mu-0/motorcontroller/kicad/parts/models/TO-220_STM.step

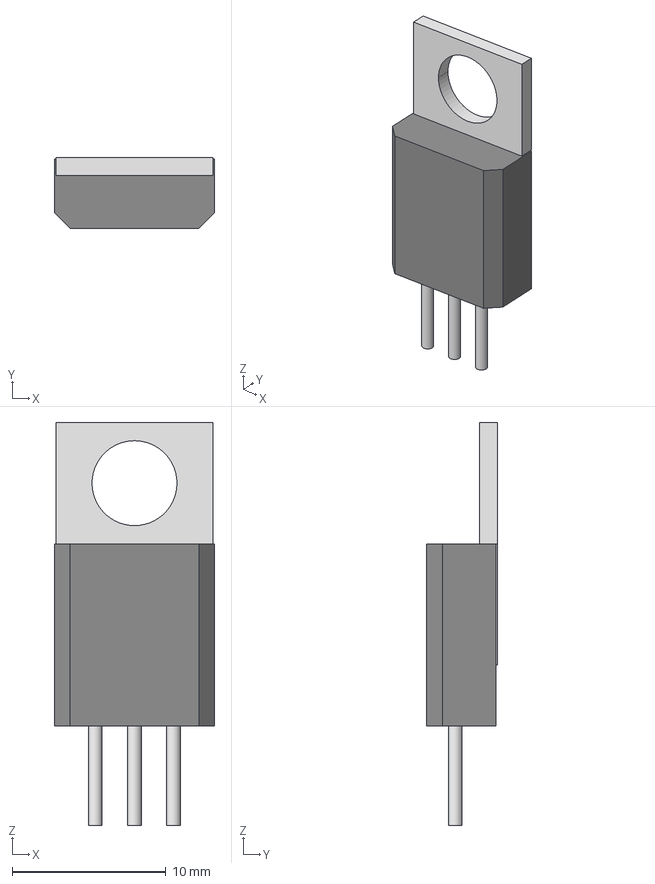
[picture p2: CAD file, 2020-12-27]
kicad/parts/models/TO-220_STM.step
10.4 x 4.60 x 26.2 mm
