mu-0/motorcontroller/kicad/parts/models/SO-8_STM.step

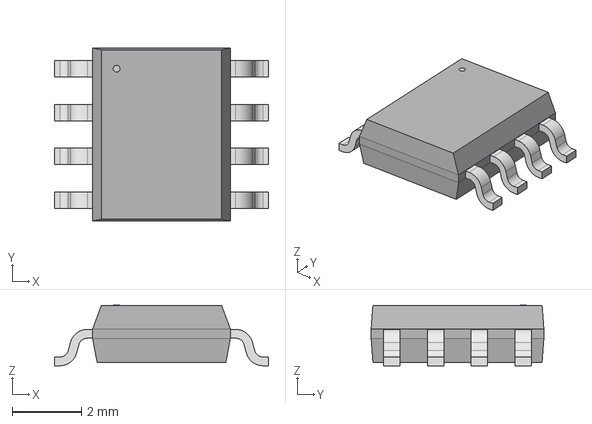
[picture p3: CAD file, 2020-12-27]
kicad/parts/models/SO-8_STM.step
6.20 x 5.00 x 1.75 mm
