mu-0/motorcontroller/kicad/motorcontroller.kicad_pcb

## KiCad design kicad/motorcontroller.kicad_pcb (2020-12-27)

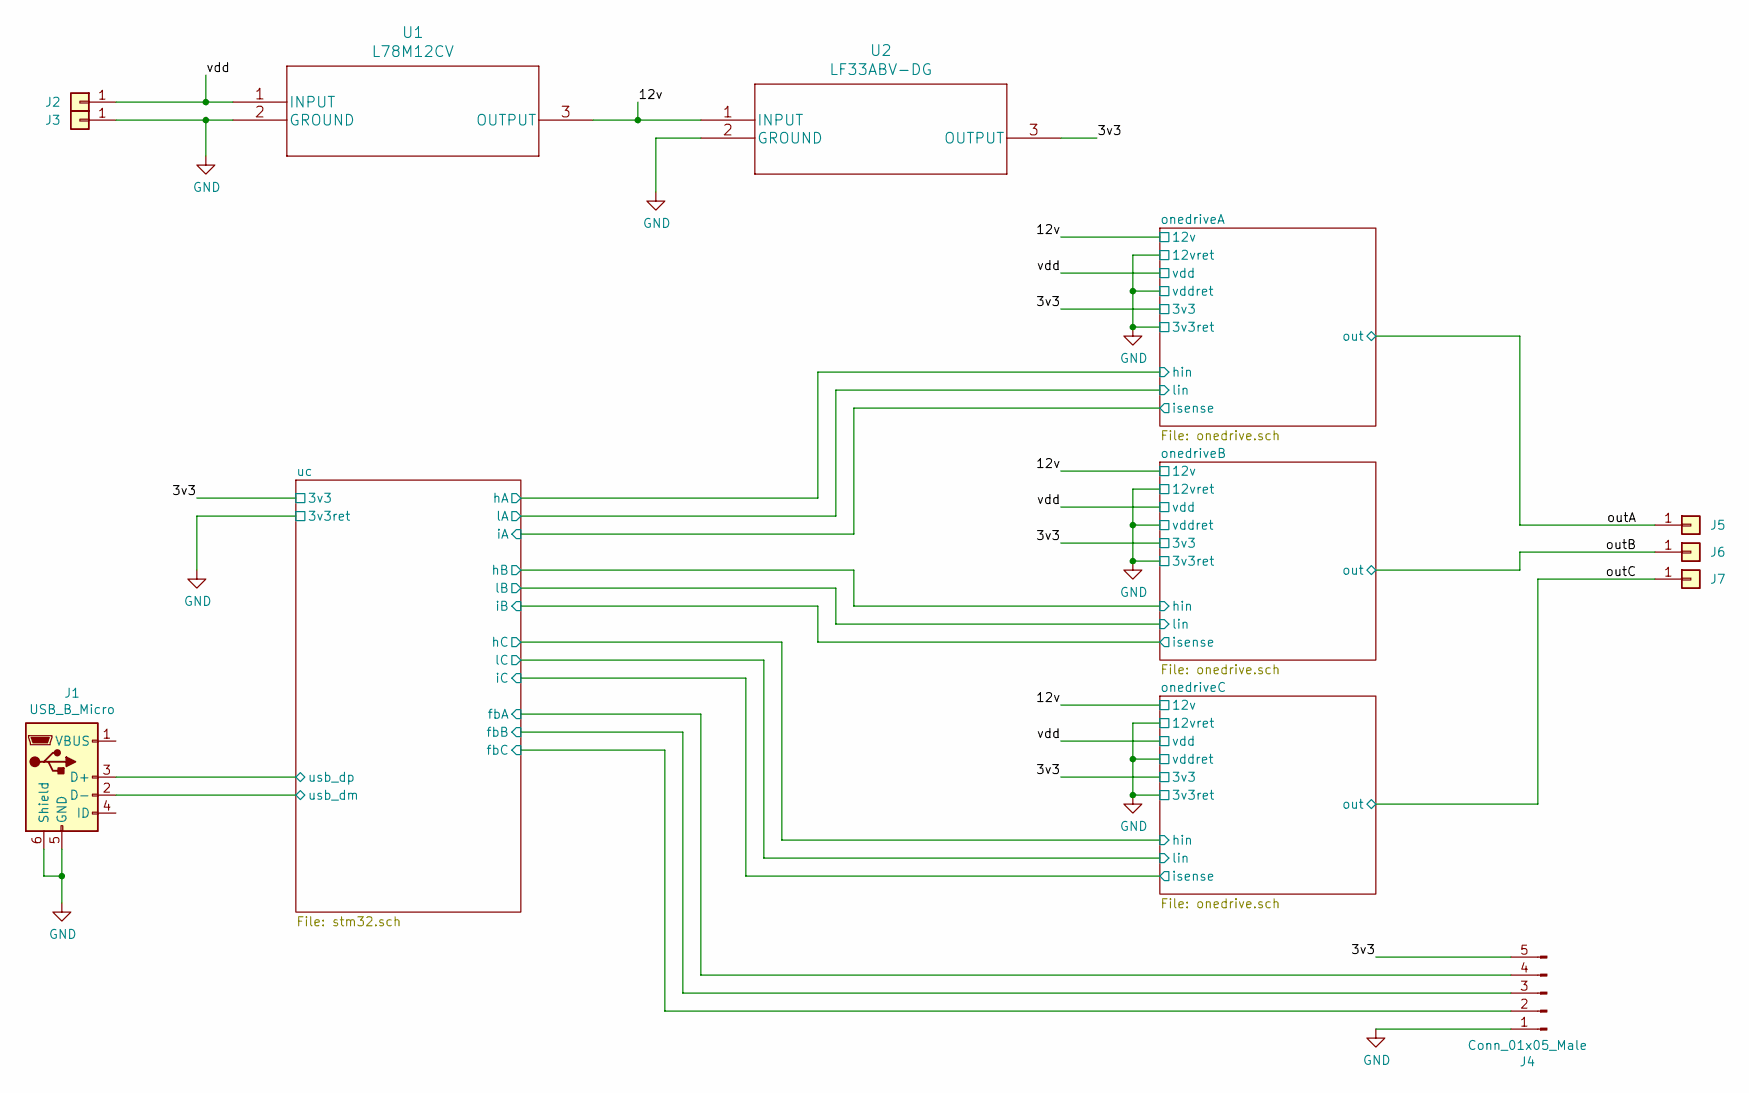
[picture p4: schematic motorcontroller.sch]

Parts:
J1: USB_B_Micro; USB_Micro-B_Molex-105133-0031
J2, J3, J5, J6, J7: Conn_01x01; Banana_Jack_1Pin
J4: Conn_01x05_Male; JST_PH_B5B-PH-SM4-TB_1x05-1MP_P2.00mm_Vertical
U1: L78M12CV
U2: LF33ABV-DG

Connections:
/3v3: J4.5, U2.3 (OUTPUT); also elsewhere on the board
/12v: U1.3 (OUTPUT), U2.1 (INPUT); also elsewhere on the board
/outA: J5.1; also elsewhere on the board
/outB: J6.1; also elsewhere on the board
/outC: J7.1; also elsewhere on the board
/uc/fbA: J4.4; also elsewhere on the board
/uc/fbB: J4.3; also elsewhere on the board
/uc/fbC: J4.2; also elsewhere on the board
/uc/usb_dm: J1.2 (D-); also elsewhere on the board
/uc/usb_dp: J1.3 (D+); also elsewhere on the board
/vdd: J2.1, U1.1 (INPUT); also elsewhere on the board
GND: J1.5 (GND), J1.6 (Shield), J3.1, J4.1, U1.2 (GROUND), U2.2 (GROUND); also elsewhere on the board

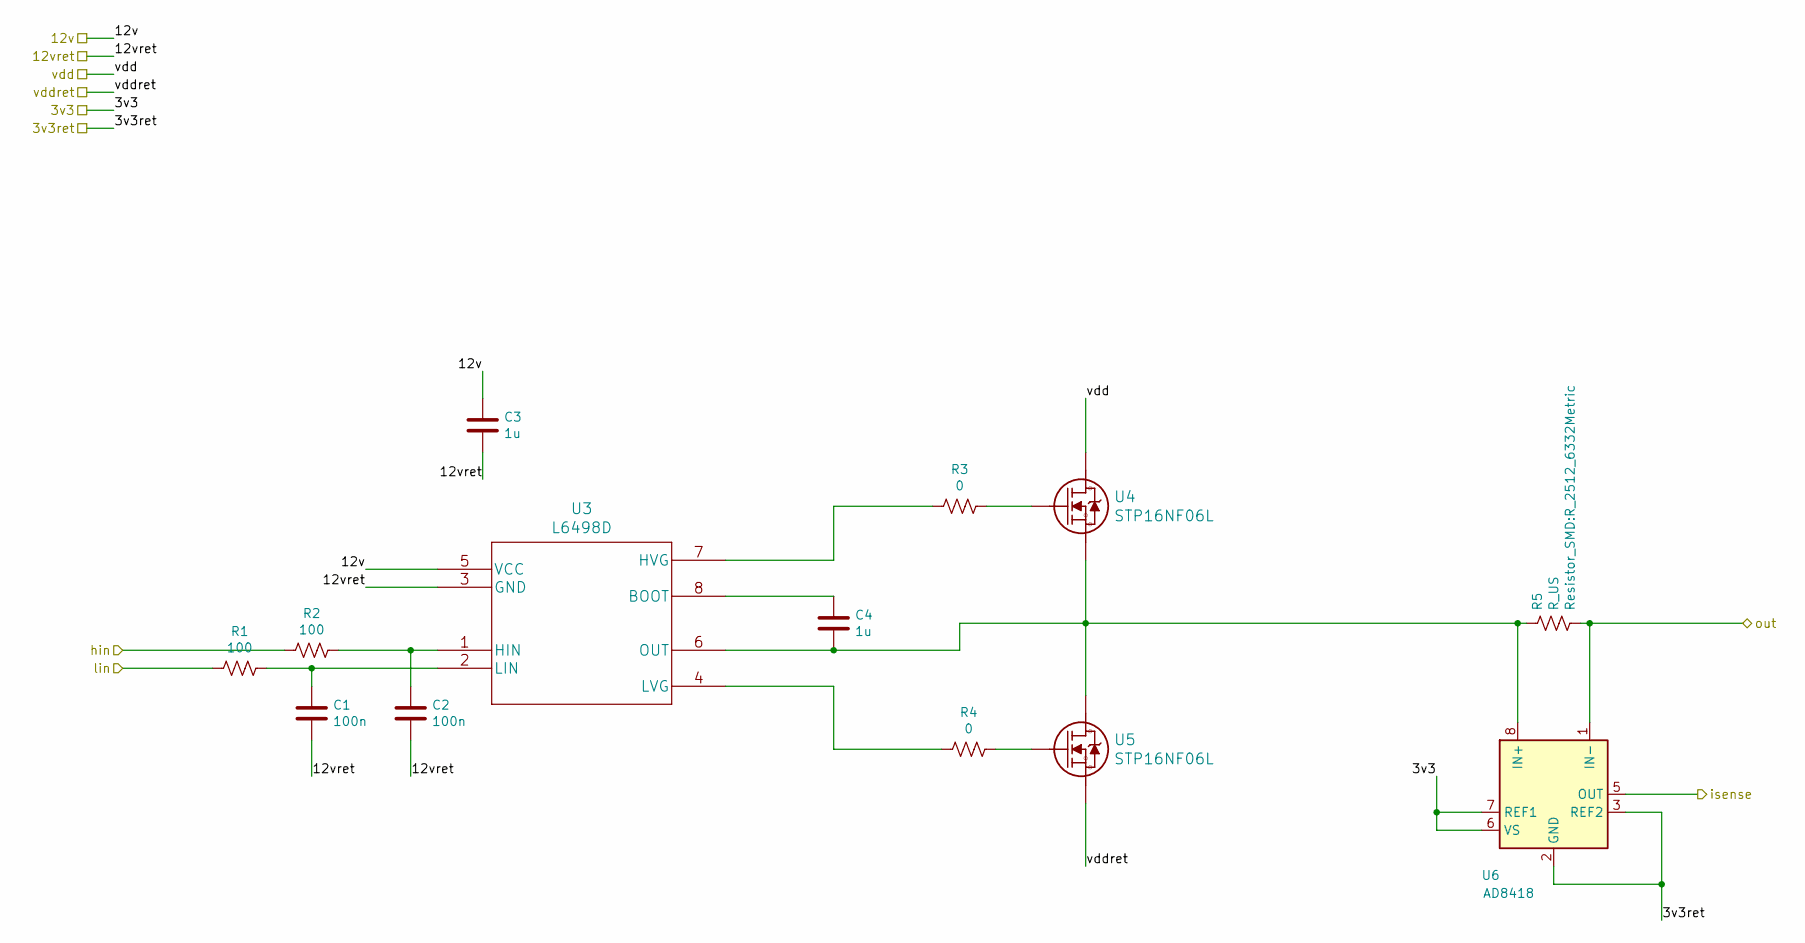
[picture p5: schematic onedrive.sch]

Parts:
C1, C2: 100n; C_0603_1608Metric_Pad1.05x0.95mm_HandSolder
C3, C4: 1u; C_0603_1608Metric_Pad1.05x0.95mm_HandSolder
R1, R2: 100; R_0603_1608Metric_Pad1.05x0.95mm_HandSolder
R3, R4: 0; R_0603_1608Metric_Pad1.05x0.95mm_HandSolder
R5: R_US; R_2512_6332Metric
U3: L6498D
U4, U5: STP16NF06L
U6: AD8418; MSOP-8_3x3mm_P0.65mm

Connections:
/3v3: U6.6 (VS), U6.7 (REF1); also elsewhere on the board
/12v: C3.1, U3.5 (VCC); also elsewhere on the board
/outA: R5.2, U6.1 (IN-); also elsewhere on the board
/uc/hA: R2.2; also elsewhere on the board
/uc/iA: U6.5 (OUT); also elsewhere on the board
/uc/lA: R1.1; also elsewhere on the board
/vdd: U4.2 (D); also elsewhere on the board
GND: C1.2, C2.2, C3.2, U3.3 (GND), U5.3 (S), U6.2 (GND), U6.3 (REF2); also elsewhere on the board
unnamed: C1.1, R1.2, U3.2 (LIN)
unnamed: C2.1, R2.1, U3.1 (HIN)
unnamed: C4.1, U3.8 (BOOT)
unnamed: C4.2, R5.1, U3.6 (OUT), U4.3 (S), U5.2 (D), U6.8 (IN+)
unnamed: R3.1, U4.1 (G)
unnamed: R3.2, U3.7 (HVG)
unnamed: R4.1, U5.1 (G)
unnamed: R4.2, U3.4 (LVG)

Parts of its further copies:
C12, C13, C16, C17: 100n; C_0603_1608Metric_Pad1.05x0.95mm_HandSolder
C14, C15, C18, C19: 1u; C_0603_1608Metric_Pad1.05x0.95mm_HandSolder
R6, R7, R11, R12: 100; R_0603_1608Metric_Pad1.05x0.95mm_HandSolder
R8, R9, R13, R14: 0; R_0603_1608Metric_Pad1.05x0.95mm_HandSolder
R10, R15: R_US; R_2512_6332Metric
U8, U12: L6498D
U9, U10, U13, U14: STP16NF06L
U11, U15: AD8418; MSOP-8_3x3mm_P0.65mm

Connections of its further copies:
/3v3: U11.6 (VS), U11.7 (REF1), U15.6 (VS), U15.7 (REF1); also elsewhere on the board
/12v: C14.1, C18.1, U8.5 (VCC), U12.5 (VCC); also elsewhere on the board
/outB: R10.2, U11.1 (IN-); also elsewhere on the board
/outC: R15.2, U15.1 (IN-); also elsewhere on the board
/uc/hB: R7.2; also elsewhere on the board
/uc/hC: R12.2; also elsewhere on the board
/uc/iB: U11.5 (OUT); also elsewhere on the board
/uc/iC: U15.5 (OUT); also elsewhere on the board
/uc/lB: R6.1; also elsewhere on the board
/uc/lC: R11.1; also elsewhere on the board
/vdd: U9.2 (D), U13.2 (D); also elsewhere on the board
GND: C12.2, C13.2, C14.2, C16.2, C17.2, C18.2, U8.3 (GND), U10.3 (S), U11.2 (GND), U11.3 (REF2), U12.3 (GND), U14.3 (S), U15.2 (GND), U15.3 (REF2); also elsewhere on the board
unnamed: C12.1, R6.2, U8.2 (LIN)
unnamed: C13.1, R7.1, U8.1 (HIN)
unnamed: C15.1, U8.8 (BOOT)
unnamed: C15.2, R10.1, U8.6 (OUT), U9.3 (S), U10.2 (D), U11.8 (IN+)
unnamed: C16.1, R11.2, U12.2 (LIN)
unnamed: C17.1, R12.1, U12.1 (HIN)
unnamed: C19.1, U12.8 (BOOT)
unnamed: C19.2, R15.1, U12.6 (OUT), U13.3 (S), U14.2 (D), U15.8 (IN+)
unnamed: R8.1, U9.1 (G)
unnamed: R8.2, U8.7 (HVG)
unnamed: R9.1, U10.1 (G)
unnamed: R9.2, U8.4 (LVG)
unnamed: R13.1, U13.1 (G)
unnamed: R13.2, U12.7 (HVG)
unnamed: R14.1, U14.1 (G)
unnamed: R14.2, U12.4 (LVG)

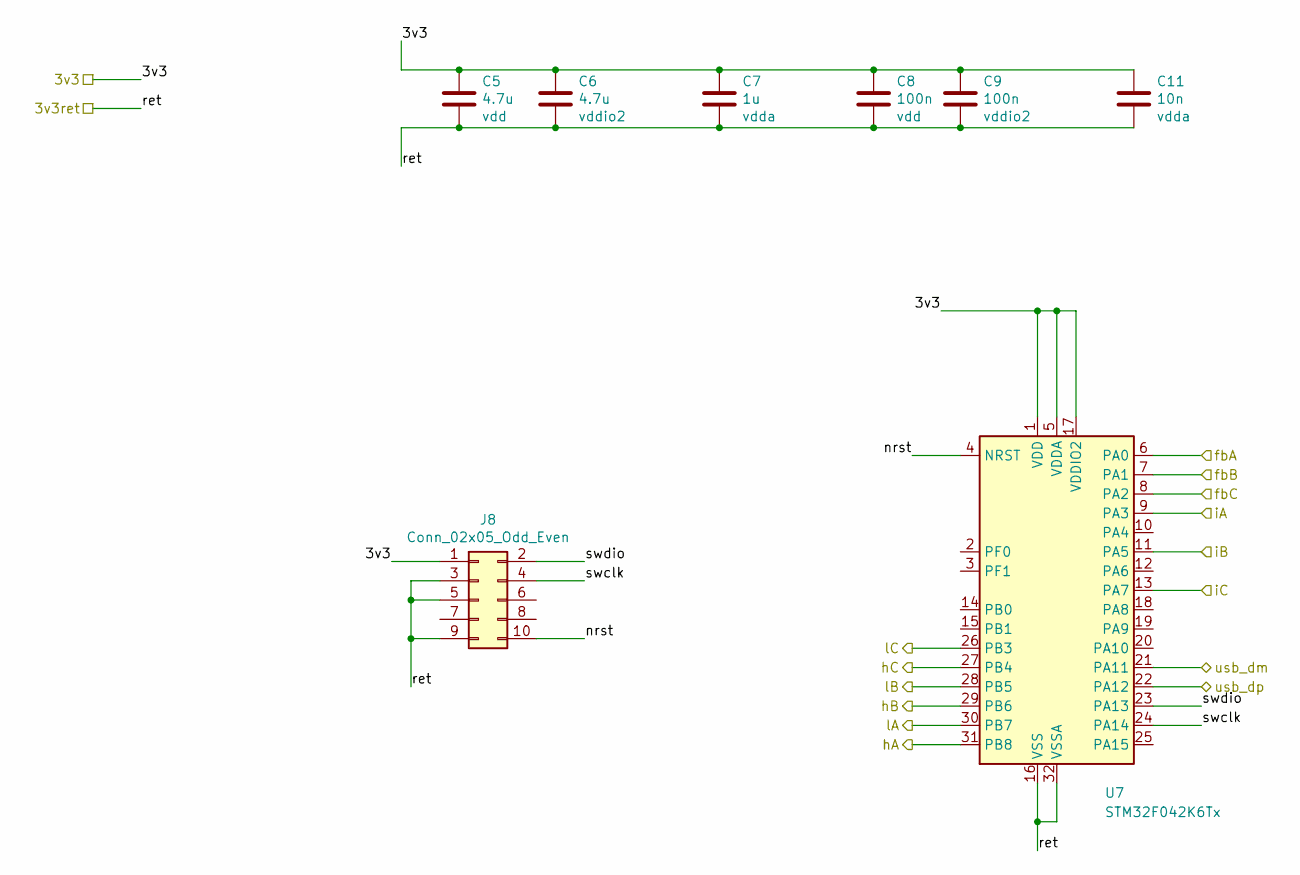
[picture p6: schematic stm32.sch]

Parts:
C5, C6: 4.7u; C_0603_1608Metric_Pad1.05x0.95mm_HandSolder
C7: 1u; C_0603_1608Metric_Pad1.05x0.95mm_HandSolder
C8, C9: 100n; C_0603_1608Metric_Pad1.05x0.95mm_HandSolder
C11: 10n; C_0603_1608Metric_Pad1.05x0.95mm_HandSolder
J8: Conn_02x05_Odd_Even; PinHeader_2x05_P1.27mm_Vertical_SMD
U7: STM32F042K6Tx; LQFP-32_7x7mm_P0.8mm

Connections:
/3v3: C5.1, C6.1, C7.1, C8.1, C9.1, C11.1, J8.1, U7.1 (VDD), U7.5 (VDDA), U7.17 (VDDIO2); also elsewhere on the board
/uc/fbA: U7.6 (PA0); also elsewhere on the board
/uc/fbB: U7.7 (PA1); also elsewhere on the board
/uc/fbC: U7.8 (PA2); also elsewhere on the board
/uc/hA: U7.31 (PB8); also elsewhere on the board
/uc/hB: U7.29 (PB6); also elsewhere on the board
/uc/hC: U7.27 (PB4); also elsewhere on the board
/uc/iA: U7.9 (PA3); also elsewhere on the board
/uc/iB: U7.11 (PA5); also elsewhere on the board
/uc/iC: U7.13 (PA7); also elsewhere on the board
/uc/lA: U7.30 (PB7); also elsewhere on the board
/uc/lB: U7.28 (PB5); also elsewhere on the board
/uc/lC: U7.26 (PB3); also elsewhere on the board
/uc/nrst: J8.10, U7.4 (NRST)
/uc/swclk: J8.4, U7.24 (PA14)
/uc/swdio: J8.2, U7.23 (PA13)
/uc/usb_dm: U7.21 (PA11); also elsewhere on the board
/uc/usb_dp: U7.22 (PA12); also elsewhere on the board
GND: C5.2, C6.2, C7.2, C8.2, C9.2, C11.2, J8.3, J8.5, J8.9, U7.16 (VSS), U7.32 (VSSA); also elsewhere on the board

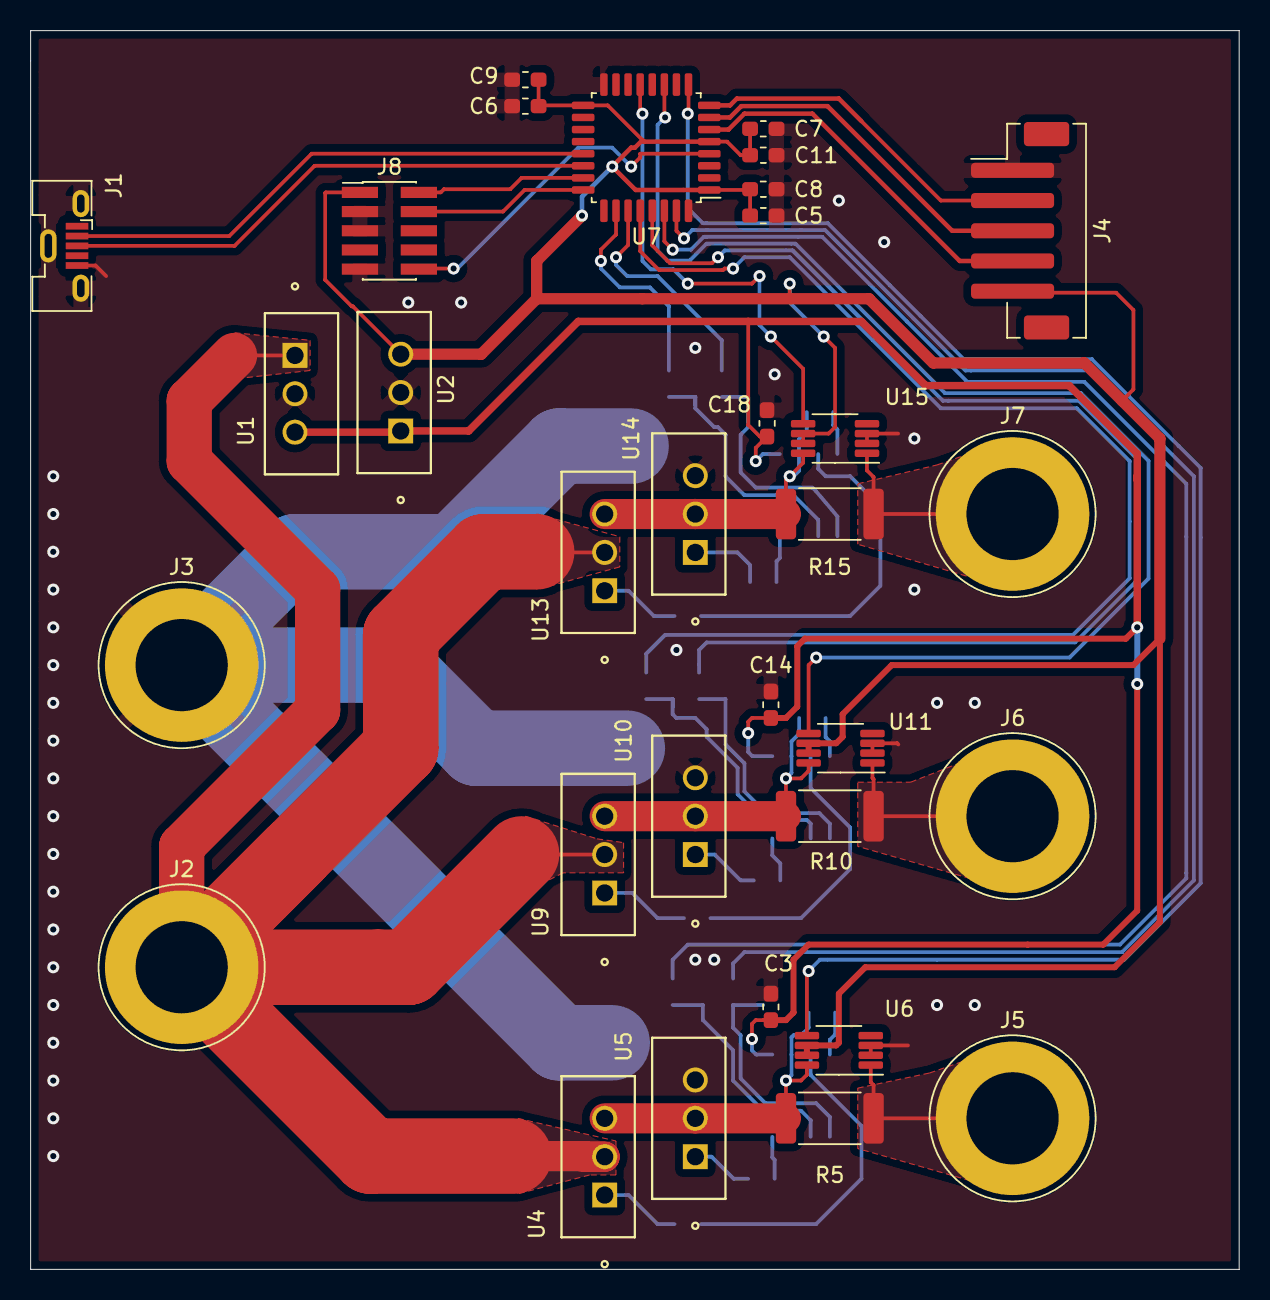
[picture p7: board motorcontroller.kicad_pcb from above]

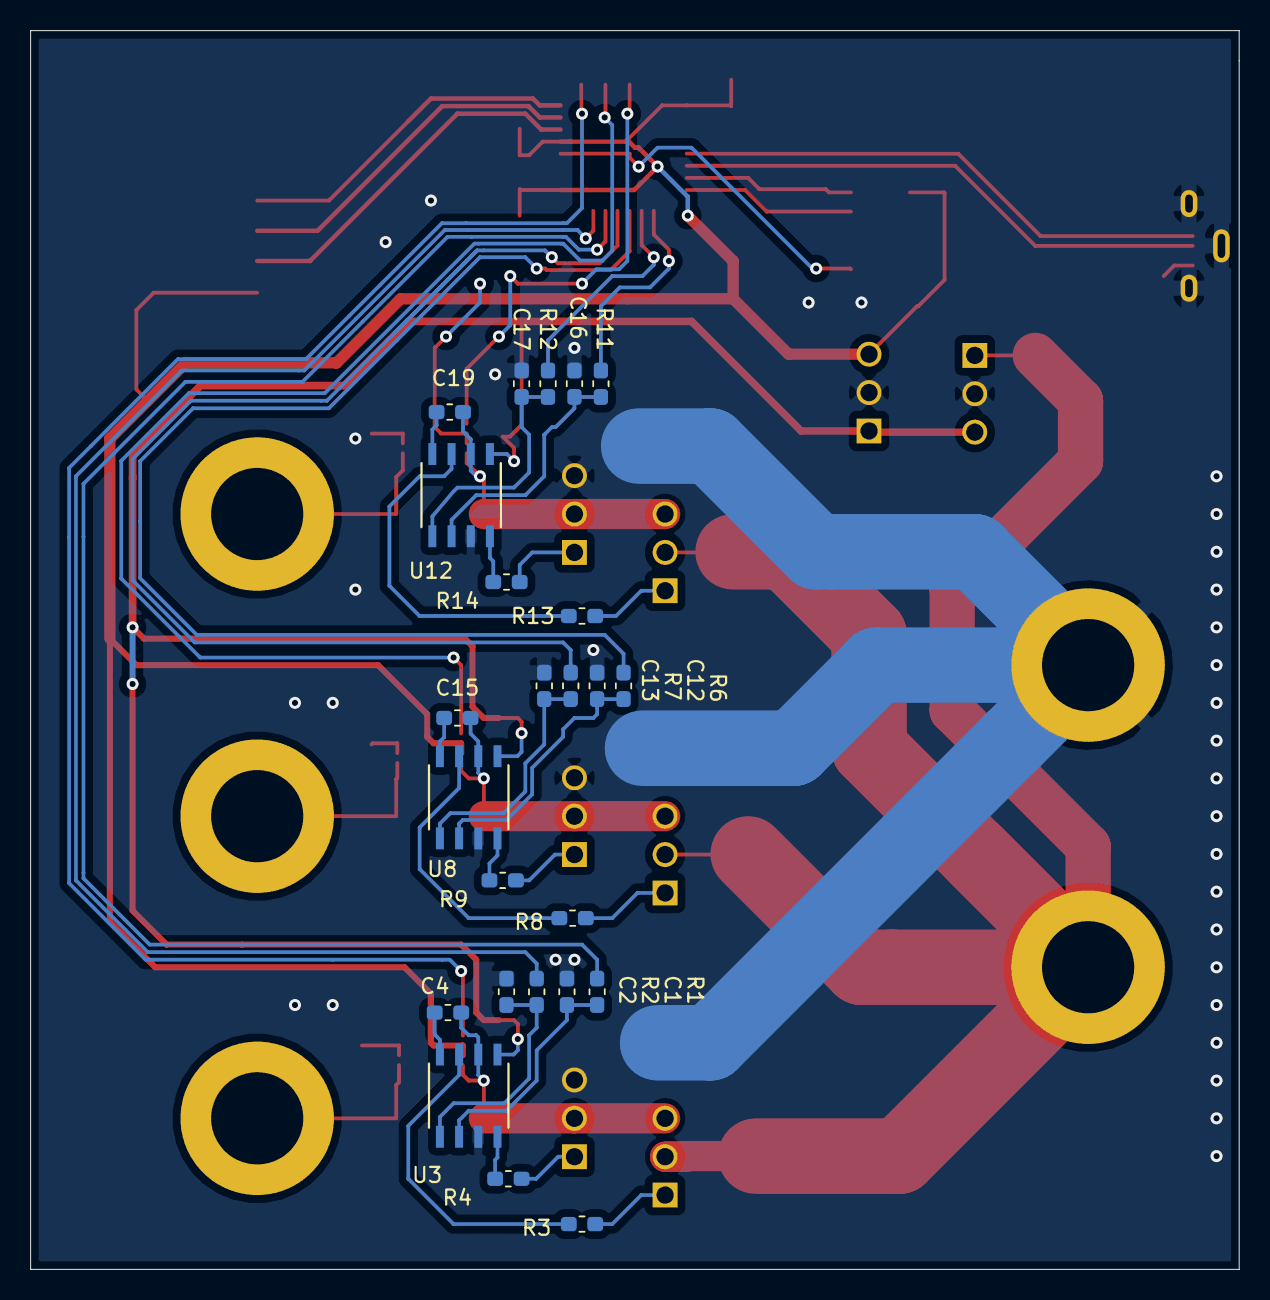
[picture p8: board motorcontroller.kicad_pcb from below]

Board: 2 copper layers, 80.0 x 82.0 mm, 56 parts (24 on the bottom side), 48 nets.
