mu-0/motorcontroller/mcsw/mcsw.ioc

Mcu.UserName=STM32F042K6Tx
PA11.Signal=USB_DM
PA12.Signal=USB_DP
PA13.Signal=SYS_SWDIO
PA14.Signal=SYS_SWCLK
